soggybag/Flatline-SMD/Flatline_render_bottom.png

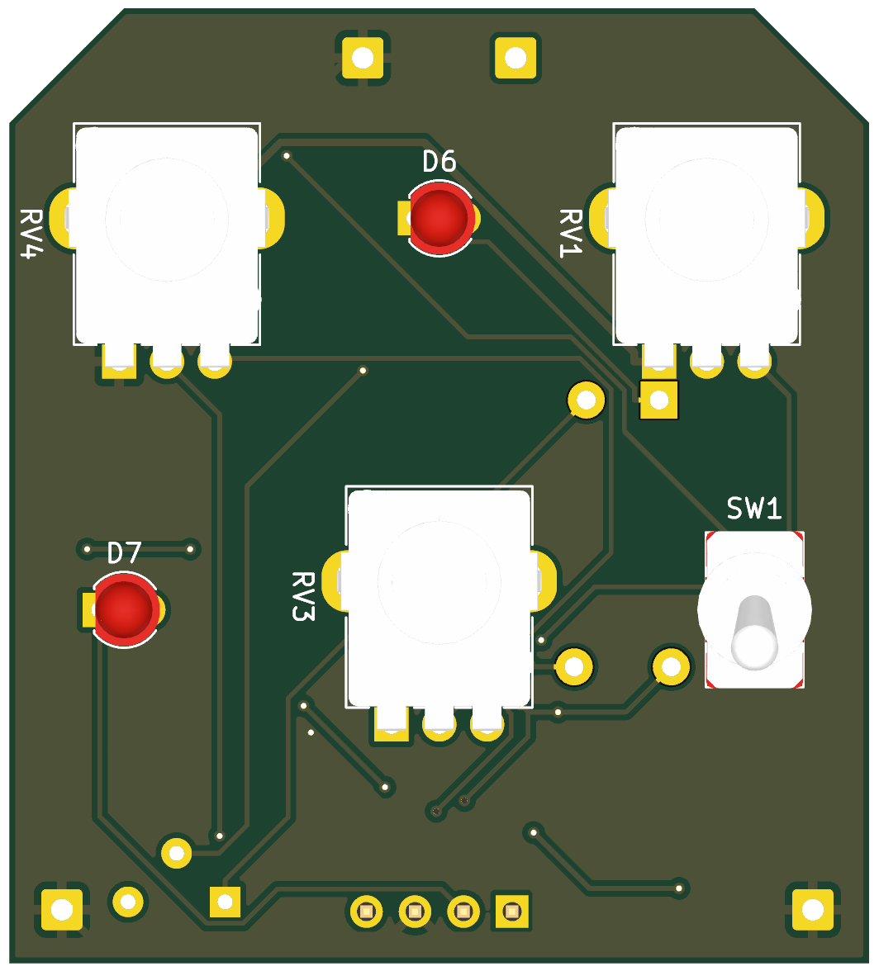
Flatline_render_bottom.png
