soggybag/Flatline-SMD/docs/Flatline_schematic.pdf

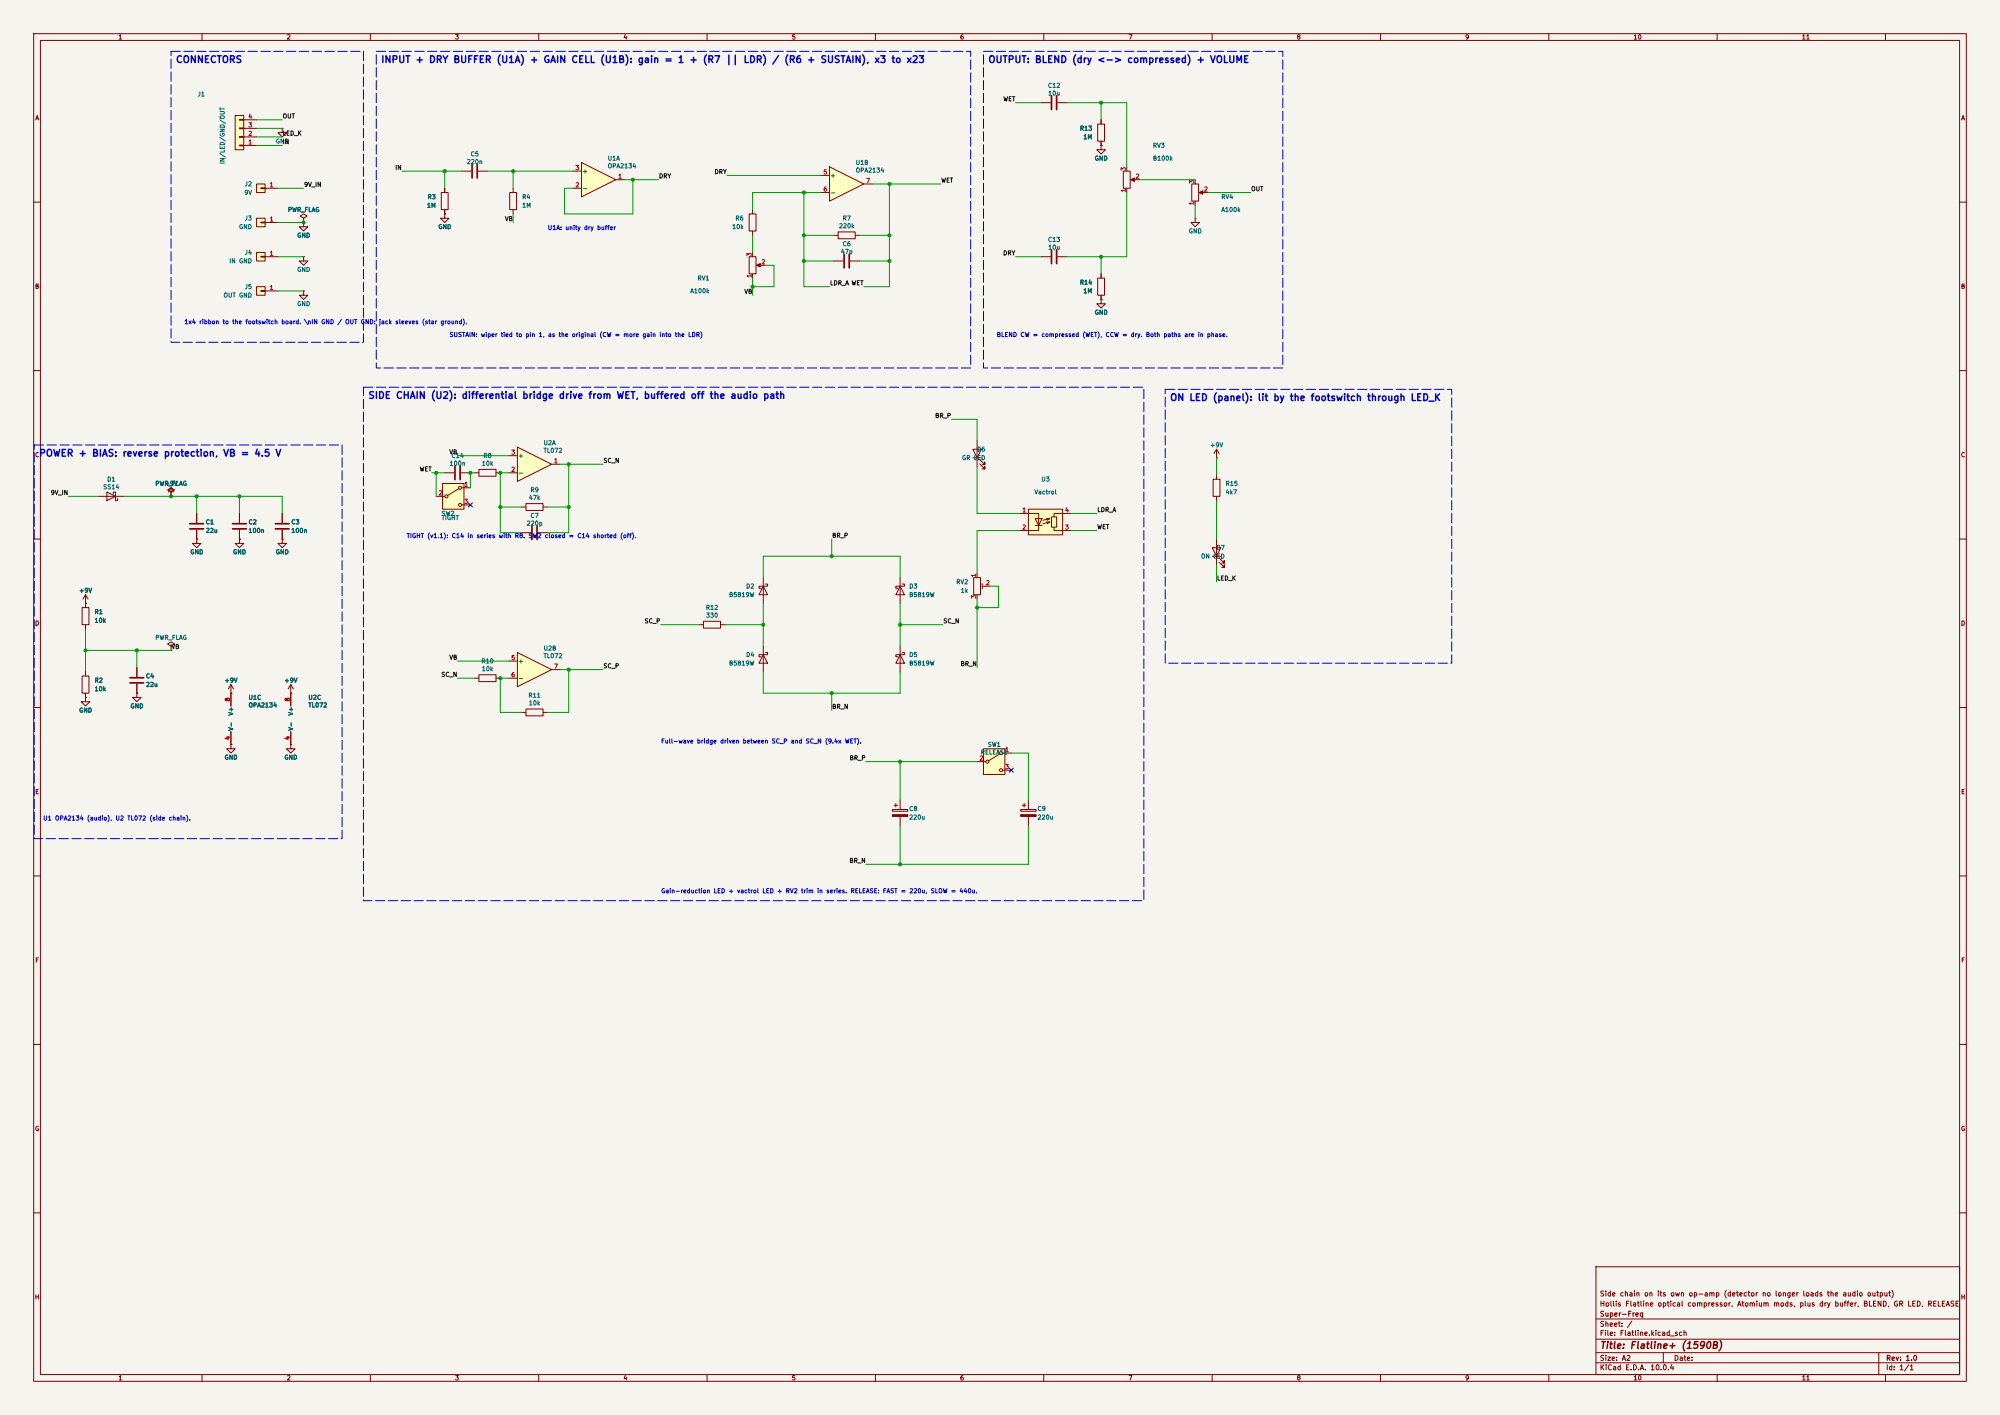
[picture p6: page 1]

INPUT + DRY BUFFER (U1A) + GAIN CELL (U1B): gain = 1 + (R7 || LDR) / (R6 + SUSTAIN), x3 to x23

OUTPUT: BLEND (dry <-> compressed) + VOLUME
7 U1B OPA2134 D2 B5819W

TIGHT (v1.1): C14 in series with R8. SW2 closed = C14 shorted (off). SUSTAIN: wiper tied to pin 1, as the original (CW = more gain into the LDR) U1A: unity dry buffer SIDE CHAIN (U2): differential bridge drive from WET, buffered off the audio path

BLEND CW = compressed (WET), CCW = dry. Both paths are in phase.

ON LED (panel): lit by the footswitch through LED_K

POWER + BIAS: reverse protection, VB = 4.5 V

Full-wave bridge driven between SC_P and SC_N (9.4x WET). Gain-reduction LED + vactrol LED + RV2 trim in series. RELEASE: FAST = 220u, SLOW = 440u.

Side chain on its own op-amp (detector no longer loads the audio output)
Hollis Flatline optical compressor, Atomium mods, plus dry buffer, BLEND, GR LED, RELEASE
Super-Freq
Sheet: /
File: Flatline.kicad_sch
Title: Flatline+ (1590B)

Size: A2 | Rev: 1.0
KiCad E.D.A. 10.0.4 | Id: 1/1
