soggybag/Flatline-SMD/archive/v1.0/Flatline_board_back.pdf

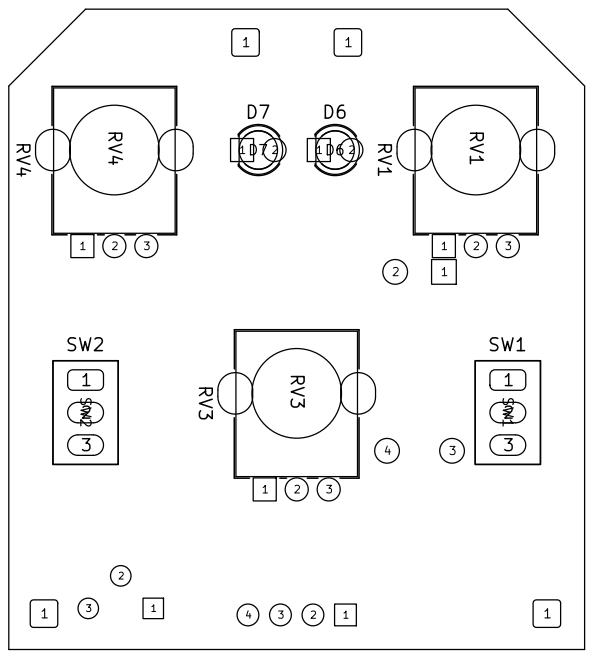
[picture p7: page 1]

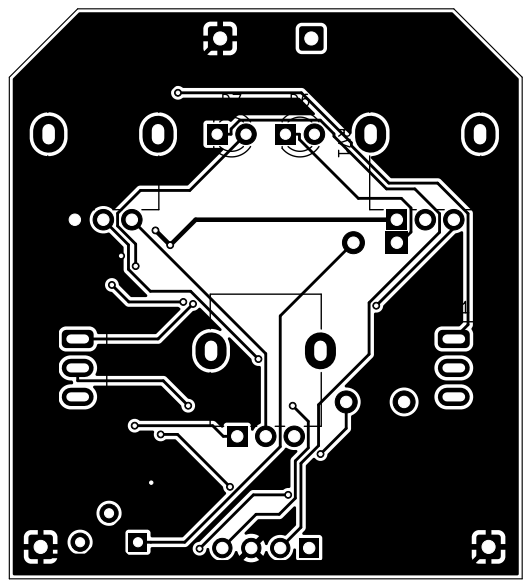
[picture p8: page 2]
