soggybag/Flatline-SMD/archive/v1.0/Flatline_board_front.pdf

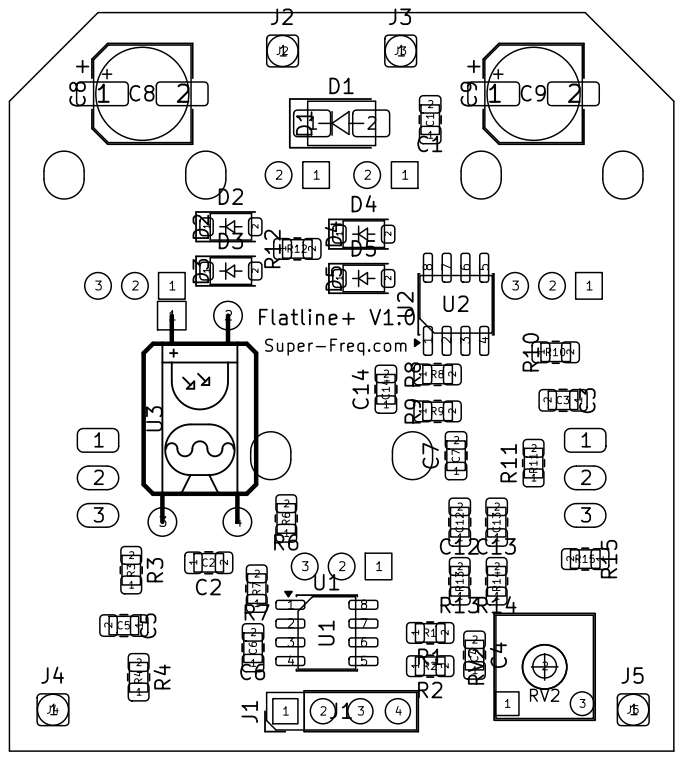
[picture p9: page 1]

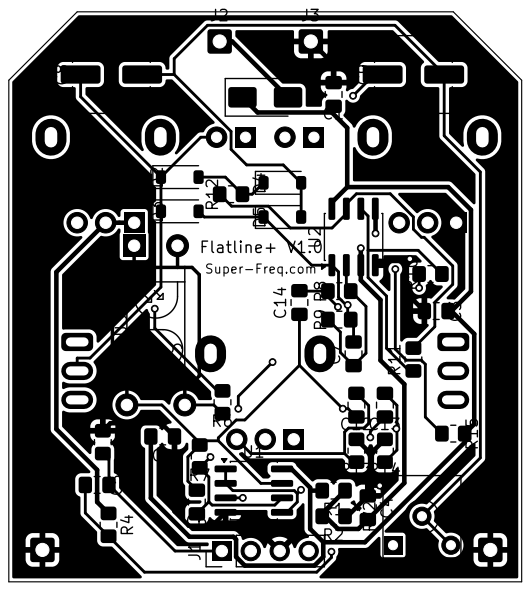
[picture p10: page 2]
