soggybag/Flatline-SMD/Flatline.kicad_pcb

## KiCad design Flatline.kicad_pcb (2026-10-19)

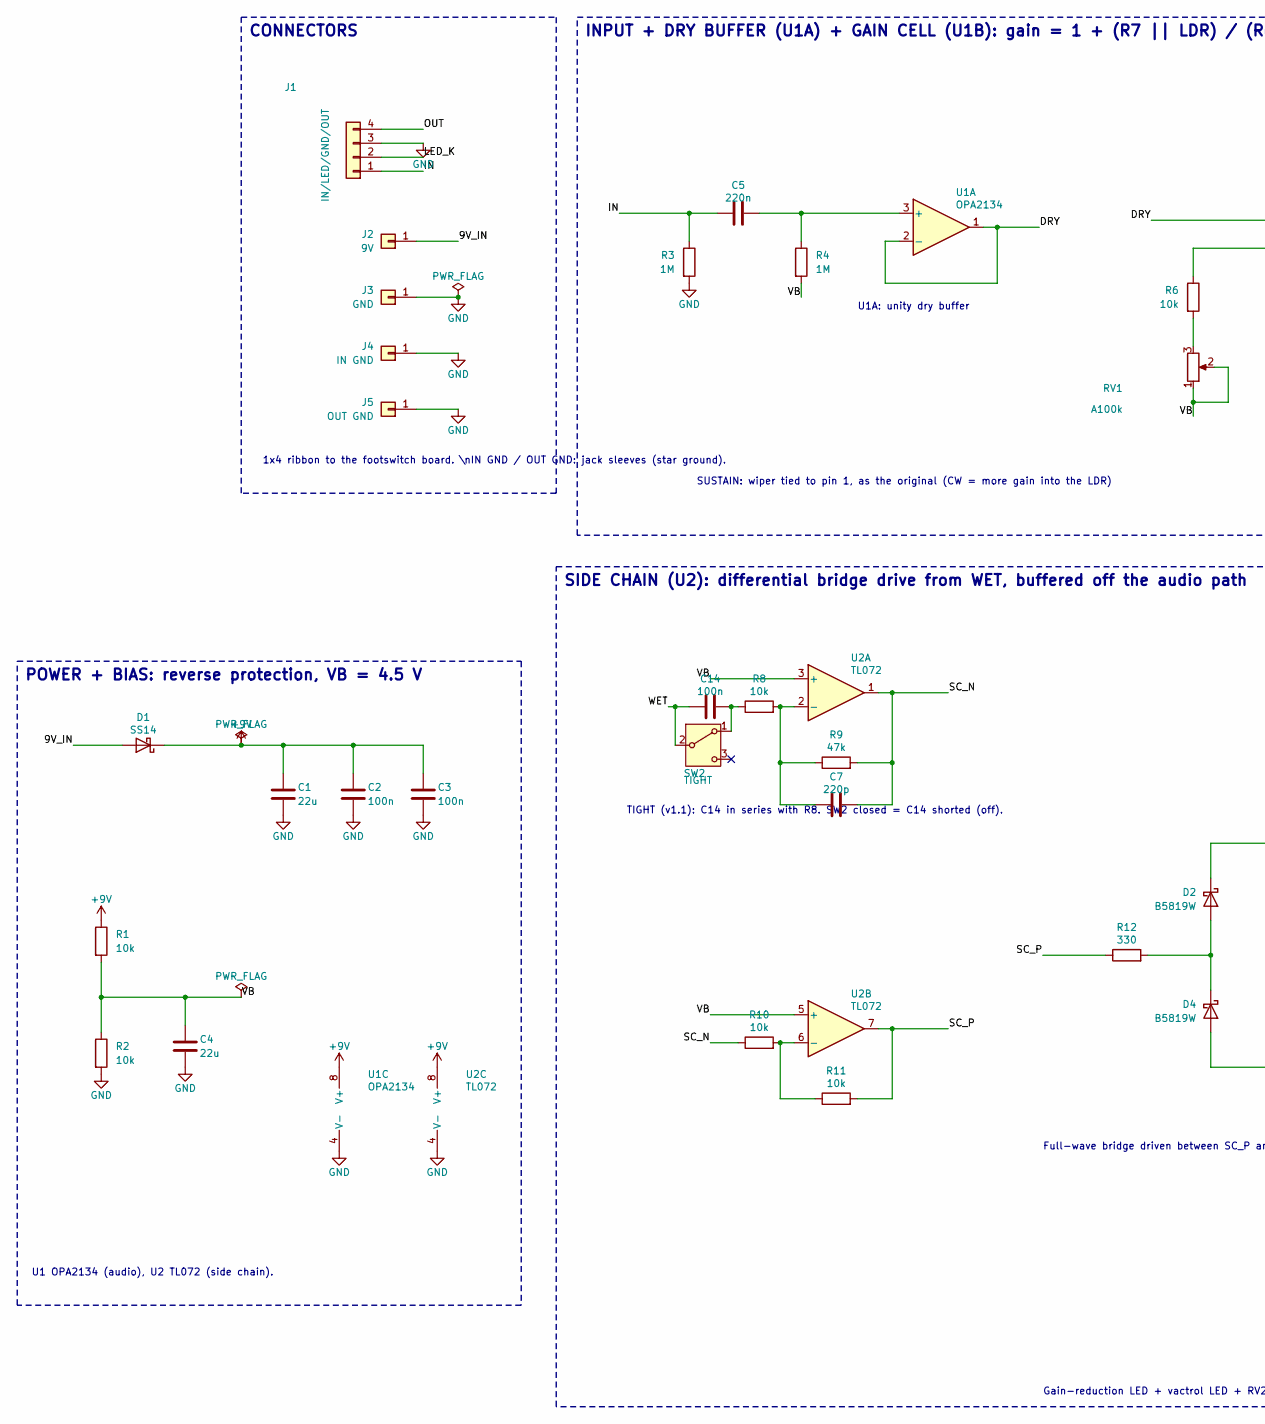
[picture p11: schematic Flatline.kicad_sch, Flatline+ (1590B), part in row 1, column 1]

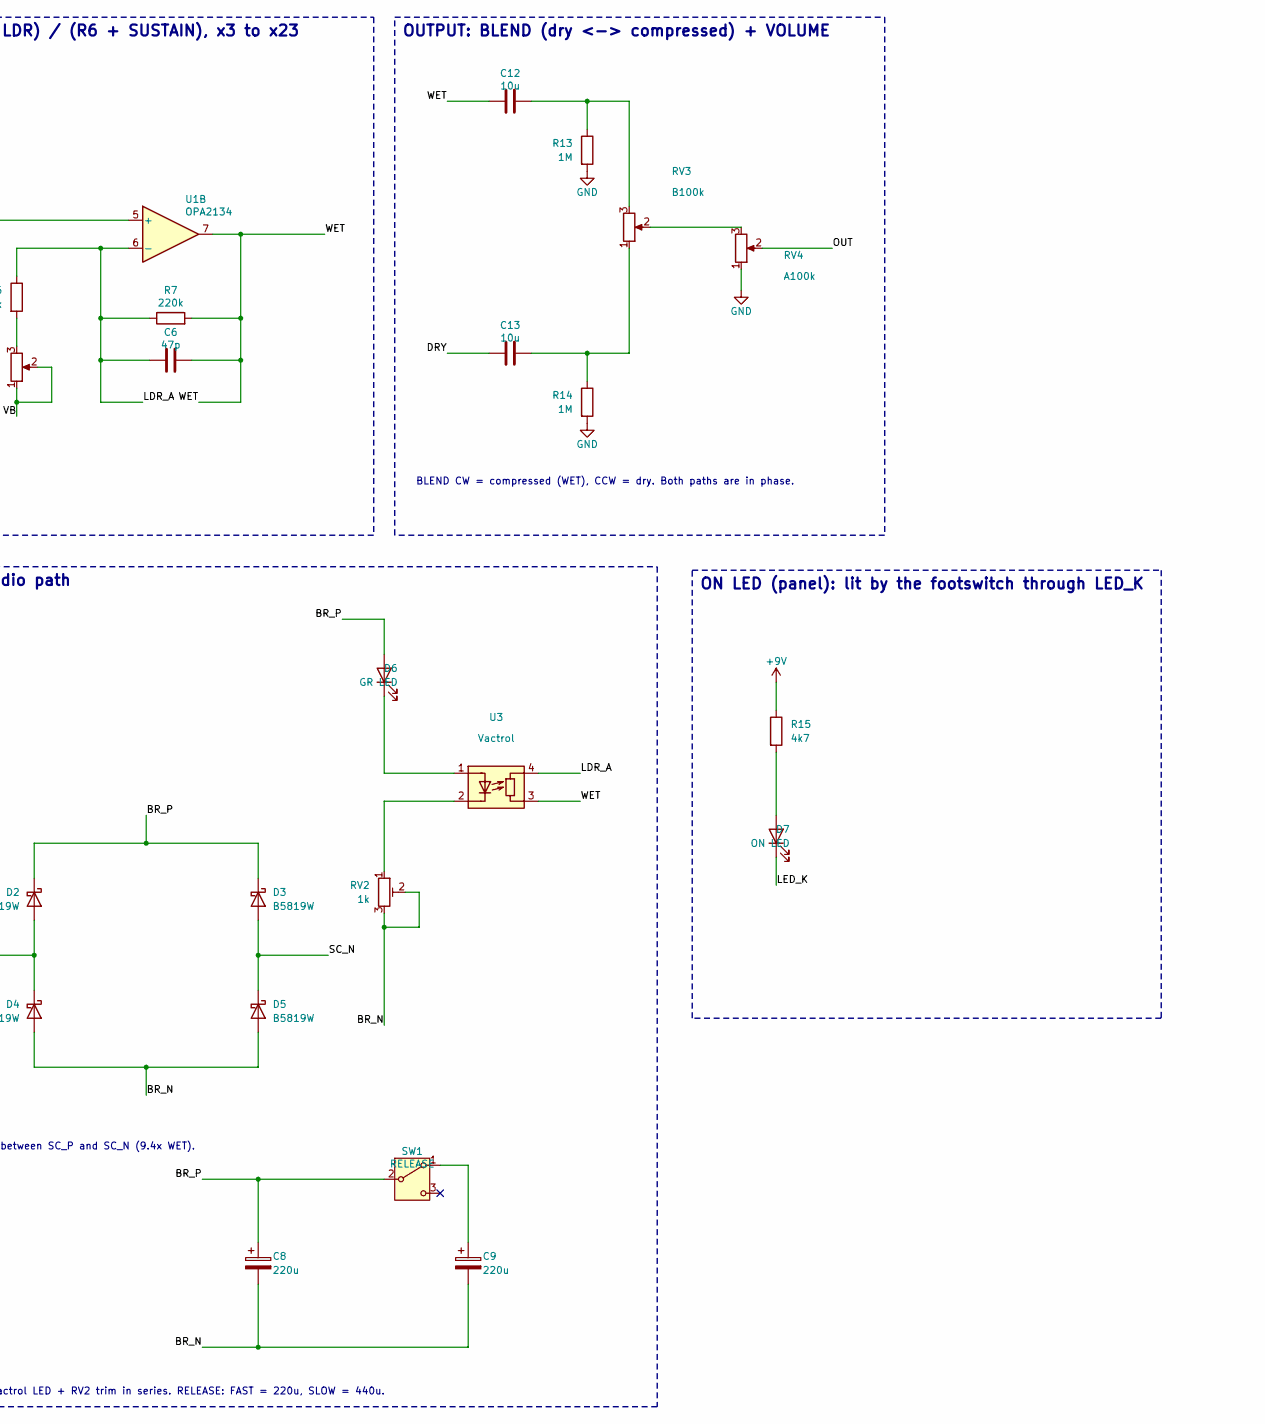
[picture p12: schematic Flatline.kicad_sch, Flatline+ (1590B), part in row 1, column 2]

Parts:
C1, C4: 22u; C_0805_2012Metric_Pad1.18x1.45mm_HandSolder; LCSC C45783
C2, C3, C14: 100n; C_0805_2012Metric_Pad1.18x1.45mm_HandSolder; LCSC C49678
C5: 220n; C_0805_2012Metric_Pad1.18x1.45mm_HandSolder; LCSC C5378
C6: 47p; C_0805_2012Metric_Pad1.18x1.45mm_HandSolder; LCSC C14857
C7: 220p; C_0805_2012Metric_Pad1.18x1.45mm_HandSolder; LCSC C107145
C8, C9: 220u; CP_Elec_6.3x7.7; LCSC C970695
C12, C13: 10u; C_0805_2012Metric_Pad1.18x1.45mm_HandSolder; LCSC C15850
D1: SS14; D_SMA; LCSC C2480
D2, D3, D4, D5: B5819W; D_SOD-123; LCSC C8598
D6: GR LED; LED_D3.0mm
D7: ON LED; LED_D3.0mm
J1: IN/LED/GND/OUT; PinHeader_1x04_P2.54mm_Vertical
J2: 9V; SolderWire-0.5sqmm_1x01_D0.9mm_OD2.1mm
J3: GND; SolderWire-0.5sqmm_1x01_D0.9mm_OD2.1mm
J4: IN GND; SolderWire-0.5sqmm_1x01_D0.9mm_OD2.1mm
J5: OUT GND; SolderWire-0.5sqmm_1x01_D0.9mm_OD2.1mm
R1, R2, R6, R8, R10, R11: 10k; R_0805_2012Metric_Pad1.20x1.40mm_HandSolder; LCSC C17414
R3, R4, R13, R14: 1M; R_0805_2012Metric_Pad1.20x1.40mm_HandSolder; LCSC C17514
R7: 220k; R_0805_2012Metric_Pad1.20x1.40mm_HandSolder; LCSC C17556
R9: 47k; R_0805_2012Metric_Pad1.20x1.40mm_HandSolder; LCSC C17713
R12: 330; R_0805_2012Metric_Pad1.20x1.40mm_HandSolder; LCSC C17630
R15: 4k7; R_0805_2012Metric_Pad1.20x1.40mm_HandSolder; LCSC C17673
RV1, RV4: A100k; Potentiometer_Alpha_RD901F-40-00D_Single_Vertical
RV2: 1k; Potentiometer_Bourns_3362P_Vertical
RV3: B100k; Potentiometer_Alpha_RD901F-40-00D_Single_Vertical
SW1: RELEASE; SW_Taiway_200_SPDT
SW2: TIGHT; SW_Taiway_200_SPDT
U1: OPA2134; SOIC-8_3.9x4.9mm_P1.27mm; LCSC C87361
U2: TL072; SOIC-8_3.9x4.9mm_P1.27mm; LCSC C6961
U3: Vactrol; Vactrol_LED_LDR_DIY

Connections:
/9V_IN: D1.2 (A), J2.1
/BR_N: C8.2, C9.2, D4.2 (A), D5.2 (A), RV2.2, RV2.3
/BR_P: C8.1, D2.1 (K), D3.1 (K), D6.2 (A), SW1.2 (B)
/DRY: C13.1, U1.1, U1.2 (-), U1.5 (+)
/IN: C5.1, J1.1, R3.1
/LDR_A: C6.1, R6.1, R7.1, U1.6 (-), U3.4 (R)
/LED_K: D7.1 (K), J1.2
/OUT: J1.4, RV4.2
/SC_N: C7.2, D3.2 (A), D5.1 (K), R9.2, R10.1, U2.1
/SC_P: R11.2, R12.1, U2.7
/WET: C6.2, C12.1, C14.1, R7.2, SW2.2 (B), U1.7, U3.3 (R)
unnamed: C12.2, R13.1, RV3.3
unnamed: C13.2, R14.1, RV3.1
unnamed: D2.2 (A), D4.1 (K), R12.2
unnamed: D6.1 (K), U3.1 (A)
unnamed: D7.2 (A), R15.2
unnamed: R6.2, RV1.3
unnamed: RV3.2, RV4.3
unnamed: C9.1, SW1.1 (A)
unnamed: C14.2, R8.1, SW2.1 (A)
unnamed: C5.2, R4.1, U1.3 (+)
unnamed: C7.1, R8.2, R9.1, U2.2 (-)
unnamed: R10.2, R11.1, U2.6 (-)
unnamed: RV2.1, U3.2 (K)

Notes on the sheet:
Full-wave bridge driven between SC_P and SC_N (9.4x WET).
BLEND CW = compressed (WET), CCW = dry. Both paths are in phase.
INPUT + DRY BUFFER (U1A) + GAIN CELL (U1B): gain = 1 + (R7 || LDR) / (R6 + SUSTAIN), x3 to x23
U1A: unity dry buffer
ON LED (panel): lit by the footswitch through LED_K
SIDE CHAIN (U2): differential bridge drive from WET, buffered off the audio path
POWER + BIAS: reverse protection, VB = 4.5 V
1x4 ribbon to the footswitch board. \nIN GND / OUT GND: jack sleeves (star ground).
U1 OPA2134 (audio), U2 TL072 (side chain).
Gain-reduction LED + vactrol LED + RV2 trim in series. RELEASE: FAST = 220u, SLOW = 440u.
SUSTAIN: wiper tied to pin 1, as the original (CW = more gain into the LDR)
CONNECTORS
OUTPUT: BLEND (dry <-> compressed) + VOLUME
TIGHT (v1.1): C14 in series with R8. SW2 closed = C14 shorted (off).

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
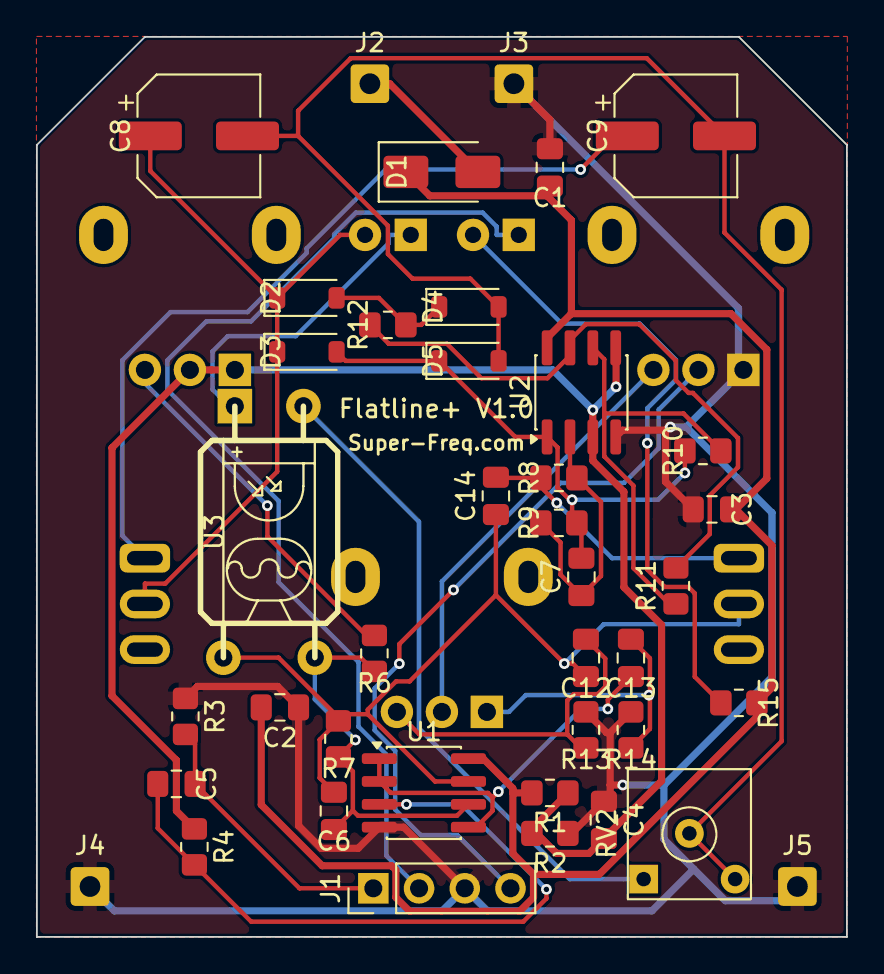
[picture p13: board Flatline.kicad_pcb from above]

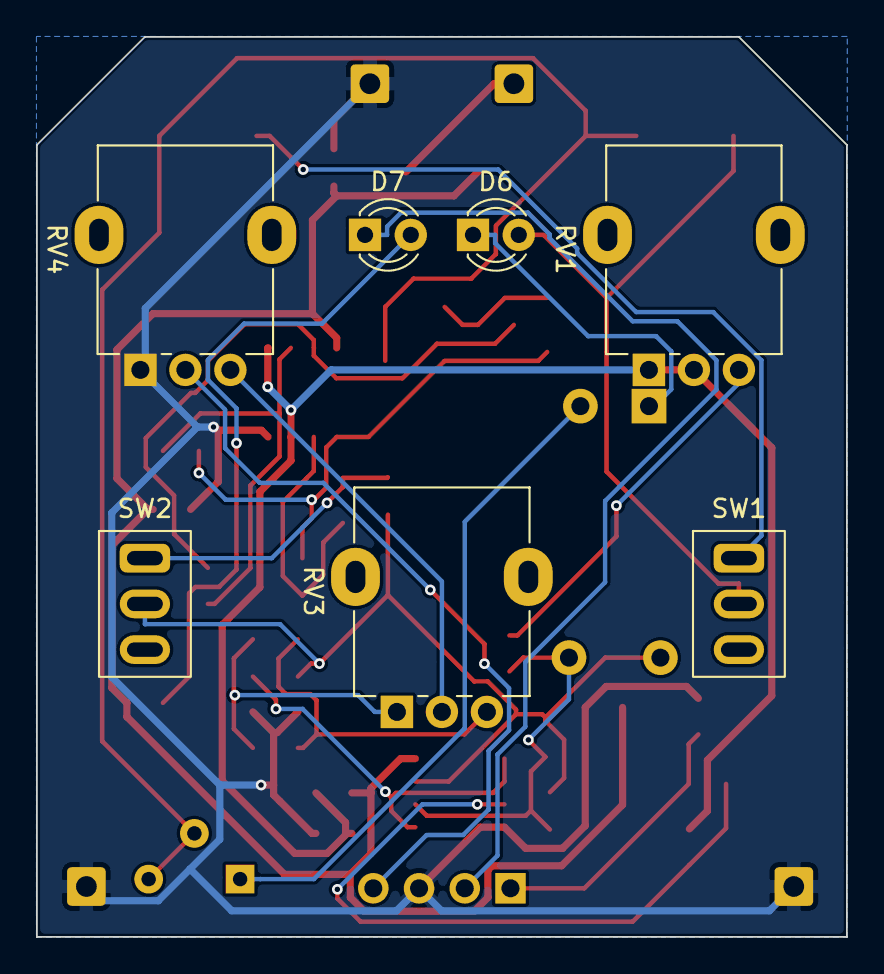
[picture p14: board Flatline.kicad_pcb from below]

Board: 2 copper layers, 45.0 x 50.0 mm, 48 parts (8 on the bottom side), 27 nets.

Other parts of the board:
ENC1: Hammond 1590B; Hammond_1590B
