soggybag/Flatline-SMD/(commit log)

2026-10-07 Flatline+ (1590B): schematic and routed board
    Hollis Flatline + Atomium mods + dry buffer, BLEND, GR LED, RELEASE, buffered side chain.
    Not ordered yet (tag v1.0 at order).
    [1590B.stp, Flatline.kicad_pcb, Flatline.kicad_sch, pot_RD901F_T18_shaft_alpha_9mm_vertical.step, switch_toggle_sub-mini_SPDT_onoff_shortlever.step]
2026-10-07 Flatline roadmap: expander (Punch Line) analysis, clean-sidechain loop idea, clipping diodes, bench experiments
2026-10-18 Flatline+: TIGHT side-chain high-pass switch (C14 100n + SW2), ON LED moved to the top row, re-routed; 1590B drill guide
    [Flatline.kicad_pcb, Flatline.kicad_sch, Flatline_1590B_drill.csv]
2026-10-19 Flatline+: board name text (Flatline+ V1.0 / Super-Freq.com), zones refilled; ready for fab
    [Flatline.kicad_pcb]
2026-10-24 Archive v1.0: schematic and board PDFs, renders, interactive BOM, parts list, docs and fab files
    [Flatline_1590B_drill.csv, Flatline_hand_solder.csv, bom.csv, designators.csv, parts.csv, positions.csv]
